RikusW/MegaU2S/Applications/Readme.md

# U2S Applications
[Example\_Echo\_test](Example_Echo_test) and [Example\_Echo\_test\_asm](Example_Echo_test_asm) Demo code using bootloader CDC driver from application code.  
[Example\_Pulse\_Counter](Example_Pulse_Counter)  
[Example\_SPI\_master](Example_SPI_master)  
[USB Blaster](Blaster20131026)  

# PC side applications
[u2scli](u2scli) Linux commandline interface to change modes  
[U2S\_GUI](U2S_GUI) Windows GUI to change modes and more  
[U2S\_Settings](U2S_Settings)  
[U2S\_Debug](U2S_Debug) Debug applications locally instead of on the AVR  

# Other AVR firmware
[ATmega8\_bootloader](ATmega8_bootloader) AVR UART bootloader
