RikusW/MegaU2S/Documentation/Images.md

# U2S:
U2S PCB
  
Artwork  
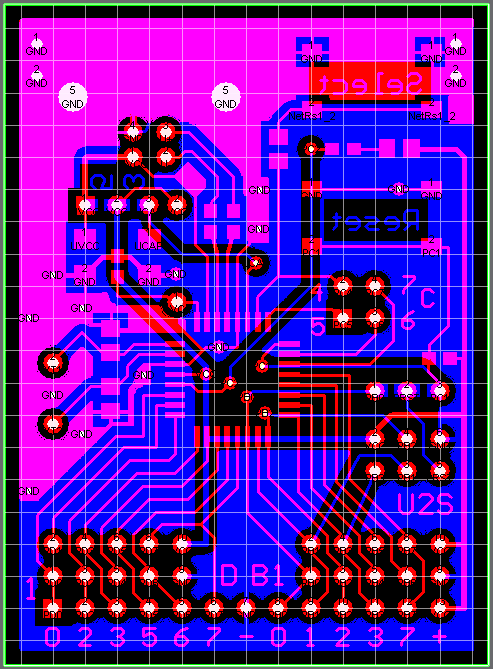
[picture p2: Documentation/files/U2S.png]
U2S artwork

  
# Extension Boards
There are 20 sets of 3 extension boards available, a HVPP board, a level translator board and a pinout adapter board for common Atmel pinouts. Thanks to megal0maniac for taking these highres photos :) [Imgur page](https://imgur.com/a/rblx5#0)  
  
HVPP/HVSP board (ST662)  
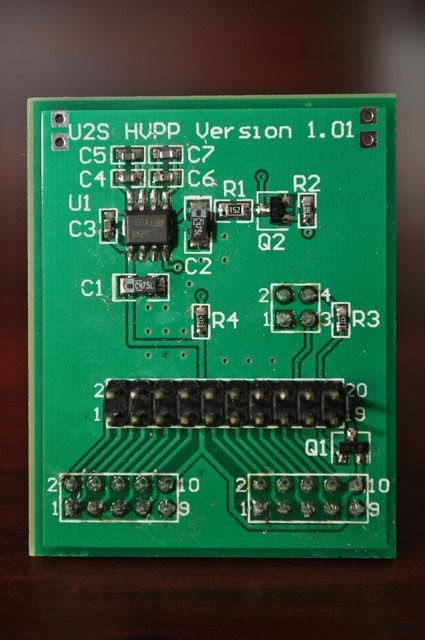
[picture p3: Documentation/files/V101_HVPP.jpg]

  
Level translator board (GTL2000DL)  
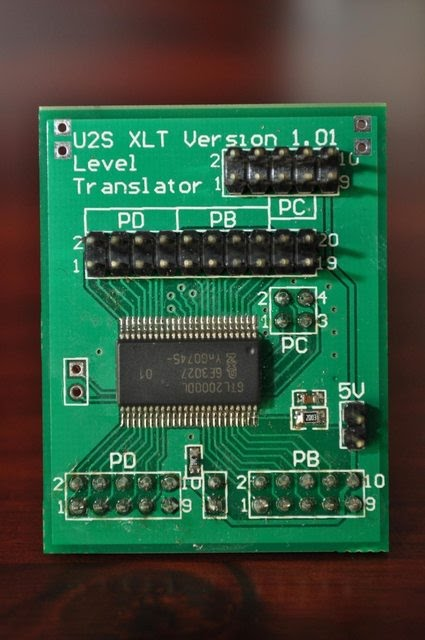
[picture p4: Documentation/files/V101_XLT.jpg]

  
Programming pinout adapter (TPI,PDI,ISP,JTAG)  
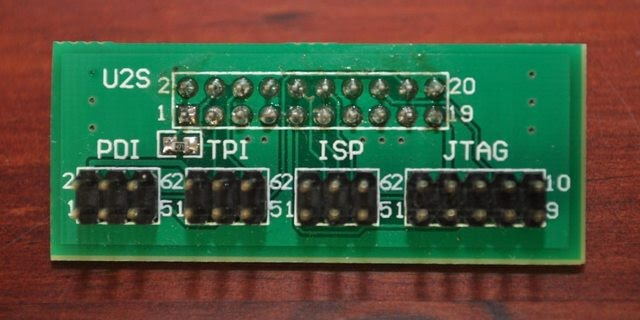
[picture p5: Documentation/files/V101_Pinout.jpg]

  
Full stack  
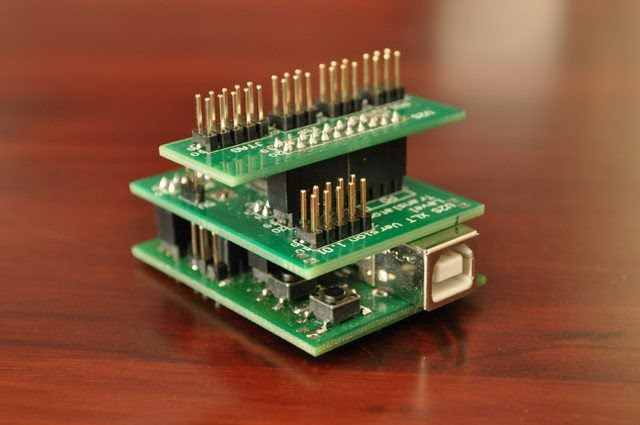
[picture p6: Documentation/files/V101_stack.jpg]

  
Artwork  
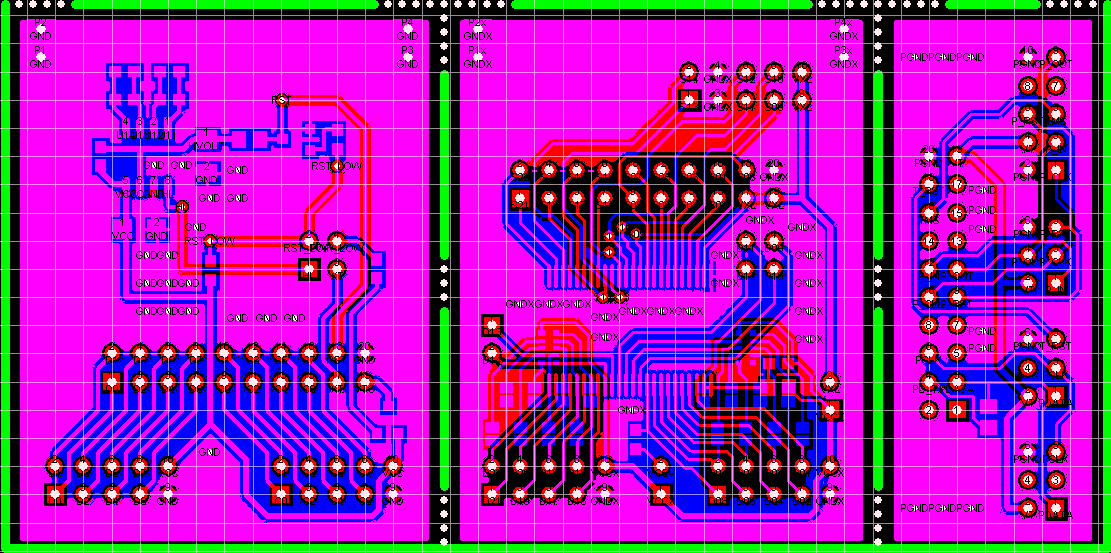
[picture p7: Documentation/files/V101_artwork.png]
Extension artwork

  
## Homemade artwork:

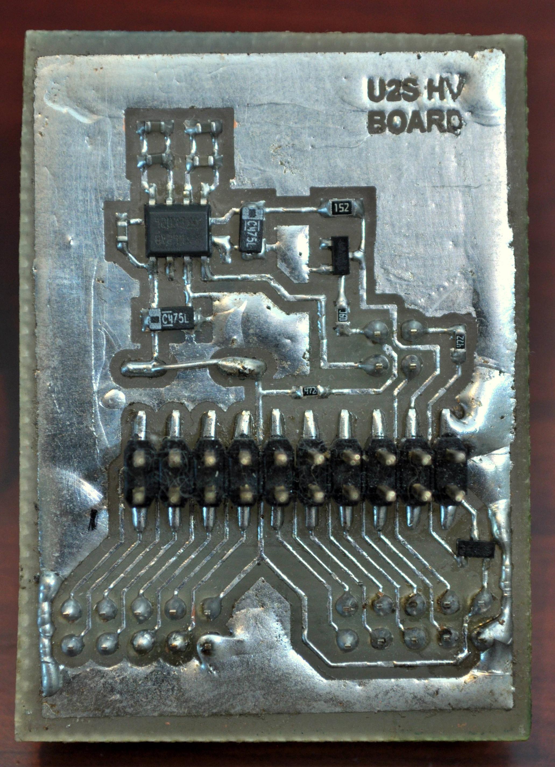
[picture p8: Documentation/files/HVPP_ST662_photo.jpg]
Homemade HVPP PCB

  
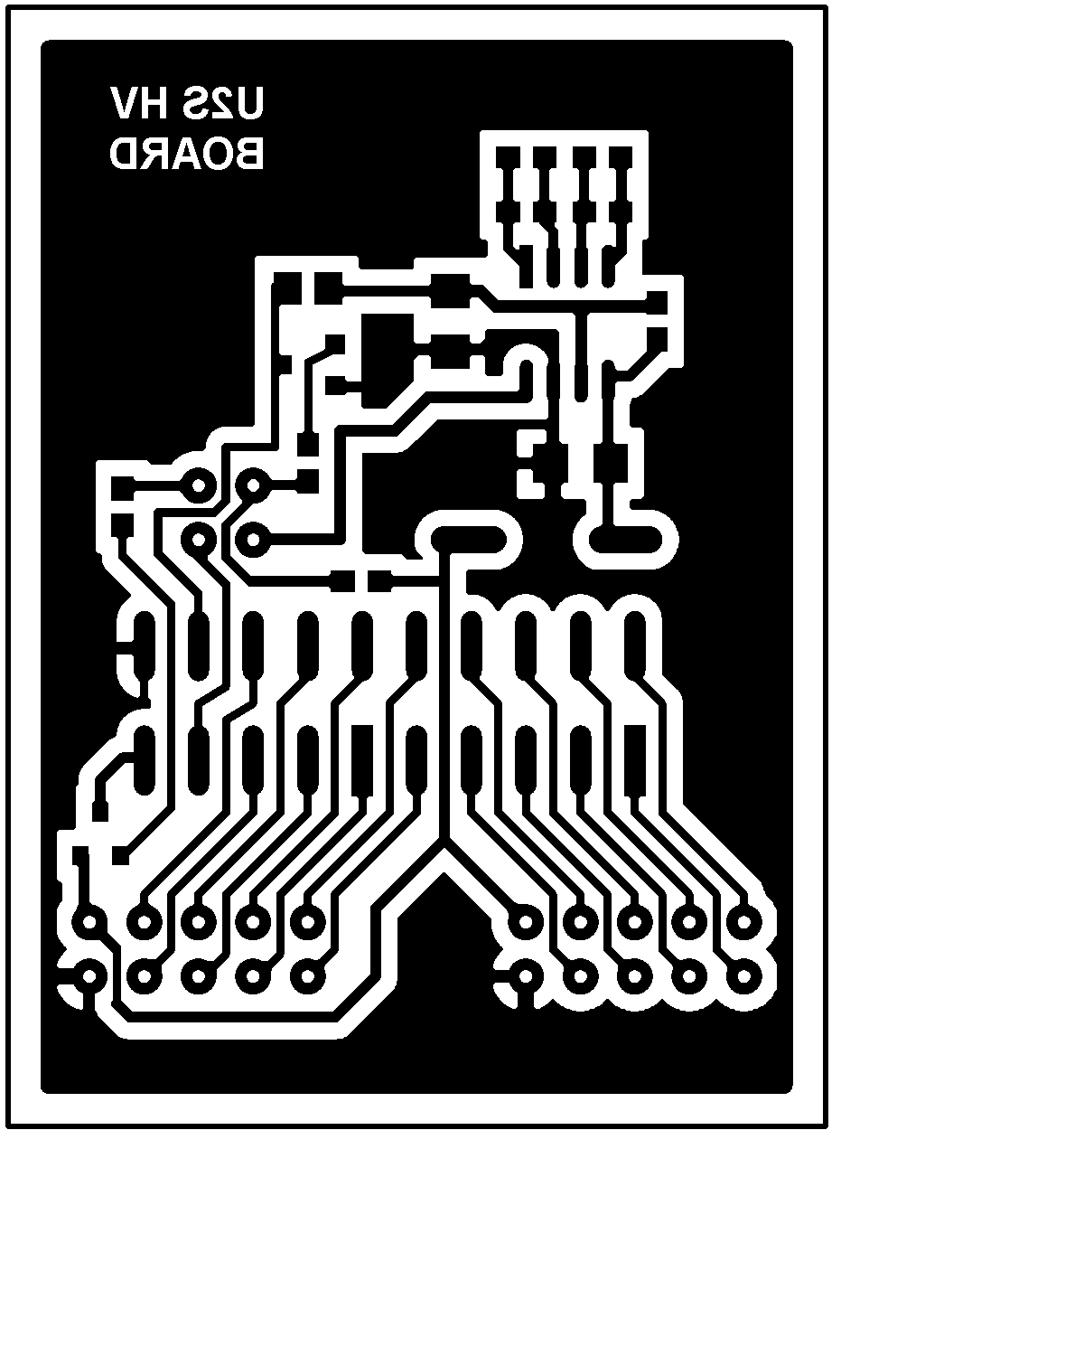
[picture p9: Documentation/files/HVPP_ST662_600dpi.png]
Homemade HVPP artwork
