RikusW/MegaU2S/(list of files, cad)

Other CAD files:
Applications/Example_Echo_test_asm/U2Sfw_asm.obj
