RikusW/MegaU2S/Altium/U2S_DXP/Test32U2.PcbDoc.htm

Altium Reporting Options

# File in Previous Format

Date | : | 6/8/2013
Time | : | 9:14:13 PM
Filename | : | C:\Documents and Settings\Rikus\My Documents\AVR_U2S\U2S_DXP\Test32U2.PcbDoc

Version | Warning
6.3 | CAUTION - Via connections to both hatched and solid signal layer polygons are now controlled by the polygon connect style rule. Re-pouring polygons may result in physical copper differences.
Summer 09 | CAUTION - File contains old violation objects. These violations are no longer supported & will not be loaded. Please run DRC after opening this file in order to refresh the violations.
Summer 09 | CAUTION - Existing testpoint rules and settings are used as fabrication testpoint information.

This file was generated by an earlier version of the software
