RikusW/MegaU2S/Applications/U2S_Debug/Readme.txt

Use U2S debug mode to access IO registers from code on PC
