RikusW/MegaU2S/(list of files, drawings)

Other design files:
Altium/U2S_DXP/ATMega32U2.PcbLib
Altium/U2S_DXP/ATMega32U2.SchLib
Altium/U2S_DXP/HC49.PcbLib
Altium/U2S_DXP/HC49.SchLib
Altium/U2S_DXP/MTS-1132.PcbLib
Altium/U2S_DXP/MTS-1132.SchLib
Altium/U2S_DXP/Test32U2.PcbDoc
Altium/U2S_DXP/Test32U2.PrjPCB
Altium/U2S_DXP/Test32U2.SchDoc
Altium/U2S_DXP/USBB.PcbLib
Altium/U2S_DXP/USBB.SchLib
Altium/U2S_HVPP_DXP/MiscComponents.PcbLib
Altium/U2S_HVPP_DXP/MiscComponents.SchLib
Altium/U2S_HVPP_DXP/U2S_HVPP.PCBDOC
Altium/U2S_HVPP_DXP/U2S_HVPP.PcbLib
Altium/U2S_HVPP_DXP/U2S_HVPP.PrjPCB
Altium/U2S_HVPP_DXP/U2S_HVPP.SchDoc
Altium/U2S_HVPP_DXP/U2S_HVPP.SchLib
Altium/U2S_HVPP_DXP/U2S_HVPP_OLD.PcbDoc
Altium/U2S_HVPP_DXP/U2S_ISP_JTAG.SchDoc
Altium/U2S_HVPP_DXP/U2S_TOP.SchDoc
Altium/U2S_HVPP_DXP/U2S_XLAT.SchDoc
