RikusW/MegaU2S/Applications/U2S_Settings/StdAfx.cpp

// stdafx.cpp : source file that includes just the standard includes
//	U2S_Settings.pch will be the pre-compiled header
//	stdafx.obj will contain the pre-compiled type information

#include "stdafx.h"
