RikusW/MegaU2S/Applications/U2S_Settings/resource.h

//{{NO_DEPENDENCIES}}
// Microsoft Developer Studio generated include file.
// Used by U2S_Settings.rc
//
#define IDM_ABOUTBOX                    0x0010
#define IDD_ABOUTBOX                    100
#define IDS_ABOUTBOX                    101
#define IDD_U2S_SETTINGS_DIALOG         102
#define IDR_MAINFRAME                   128
#define IDC_COMBO_MODE                  1000
#define IDC_COMBO_ISP                   1001
#define IDC_BREFRESH                    1002
#define IDC_EMSG                        1003
#define IDC_BDEFAULTS                   1004

// Next default values for new objects
// 
#ifdef APSTUDIO_INVOKED
#ifndef APSTUDIO_READONLY_SYMBOLS
#define _APS_NEXT_RESOURCE_VALUE        129
#define _APS_NEXT_COMMAND_VALUE         32771
#define _APS_NEXT_CONTROL_VALUE         1005
#define _APS_NEXT_SYMED_VALUE           101
#endif
#endif
