RikusW/MegaU2S/Firmware/JtagIce/Debug.asm

#ifdef DEBUG
//for debugging in the simulator

inject:
.db 0x53,0x20,0x20,0x00,0x00,0x00,0x00,0x00 //signon
.db 0x42,0x86,0xFA,0x20,0x20,0x00,0x00,0x00 //setparameter
.db 0x42,0x88,0xA5,0x20,0x20,0x00,0x00,0x00 //setparameter
.db 0x42,0x89,0xA6,0x20,0x20,0x00,0x00,0x00 //setparameter
.db 0x42,0x8A,0xA7,0x20,0x20,0x00,0x00,0x00 //setparameter
.db 0x71,0x62,0x20,0x20,0x00,0x00,0x00,0x00 //getparameter
.db 0x62,0x63,0x62,0x63,0x20,0x20,0x20,0x20
.db 0x00,0x00,0x00,0x00,0x00,0x00,0x00,0x00
.db 0xa3,0x20,0x20,0x00,0x00,0x00,0x00,0x00
.db 0x00,0x00,0x00,0x00,0x00,0x00,0x00,0x00
.db 0x00,0x00,0x00,0x00,0x00,0x00,0x00,0x00
.db 0x00,0x00,0x00,0x00,0x00,0x00,0x00,0x00
.db 0,0xA0 //Set Device Descriptor -- tested ok
.db 0xCF,0x2F,0xFF,0xFF,0xFF,0xFF,0xFF,0xFF,0x00,0x00,0x00,0x00,0x00,0x00,0x00,0x00
.db 0xCF,0x27,0xFF,0xFF,0xFF,0xFF,0xFF,0xFE,0x00,0x00,0x00,0x00,0x00,0x00,0x00,0x00
.db 0x3E,0xB5,0x1F,0x37,0xFF,0x1F,0x21,0x2F,0x00,0x00,0x00,0x00,0x00,0x00,0x00,0x00,0x00,0x00,0x00,0x00
.db 0x00,0x00,0x00,0x00,0x00,0x00,0x00,0x00,0x00,0x00,0x00,0x00,0x00,0x00,0x00,0x00,0x00,0x00,0x00,0x00
.db 0x3E,0xB5,0x0F,0x27,0xFF,0x1F,0x21,0x27,0x00,0x00,0x00,0x00,0x00,0x00,0x00,0x00,0x00,0x00,0x00,0x00
.db 0x00,0x00,0x00,0x00,0x00,0x00,0x00,0x00,0x00,0x00,0x00,0x00,0x00,0x00,0x00,0x00,0x00,0x00,0x00,0x00
.db 0x22, 0x68, 0x3B, 0, 1, 8, 0x00, 0xFE, 0x00, 0x00, 0x9D, 0x20,0x20,0


getc: //debug
	push	r30
	push	r31
	movw	r30,r26
	lpm		r16,Z+
	movw	r26,r30
	pop		r31
	pop		r30
	ret
/*
peekc:
	ldi		r26,lo8(inject*2)
	ldi		r27,hi8(inject*2)
	add		r26,r3    //db
	adc		r27,rnull //db
	clz //always available*/
flush:
	ret
putc:
	ret
putc_nf:
	ret

#endif
