RikusW/MegaU2S/Applications/U2S_GUI/resource.h

//{{NO_DEPENDENCIES}}
// Microsoft Developer Studio generated include file.
// Used by U2S_GUI.rc
//
#define IDM_ABOUTBOX                    0x0010
#define IDD_ABOUTBOX                    100
#define IDS_ABOUTBOX                    101
#define IDD_U2S_GUI_DIALOG              102
#define IDR_MAINFRAME                   128
#define IDD_DIALOG_DEBUG                131
#define IDD_U2S_DEBUG                   131
#define IDD_U2S_SETTINGS_DIALOG         132
#define IDD_U2S_USART                   133
#define IDC_CHECK1                      1001
#define IDC_CHECK2                      1002
#define IDC_CHECK3                      1003
#define IDC_CHECK4                      1004
#define IDC_CHECK5                      1005
#define IDC_CHECK6                      1006
#define IDC_CHECK7                      1007
#define IDC_CHECK8                      1008
#define IDC_EDIT1                       1009
#define IDC_EDIT2                       1010
#define IDC_EDIT3                       1011
#define IDC_EDIT4                       1012
#define IDC_EDIT5                       1013
#define IDC_EDIT6                       1014
#define IDC_EDIT7                       1015
#define IDC_EDIT8                       1016
#define IDC_LIST1                       1017
#define IDC_BUTTON1                     1018
#define IDC_BUTTON2                     1019
#define IDC_BUTTON3                     1020
#define IDC_BUTTON4                     1021
#define IDC_CHECK9                      1022
#define IDC_BUTTON8                     1022
#define IDC_BUTTON5                     1023
#define IDC_EDIT9                       1024
#define IDC_EDIT10                      1025
#define IDC_BUTTON6                     1026
#define IDC_EDIT11                      1027
#define IDC_BUTTON7                     1028
#define IDC_BUTTON9                     1029
#define IDC_EDIT12                      1030
#define IDC_COMBO1                      1031
#define IDC_BUTTON10                    1032
#define IDC_COMBO2                      1032
#define IDC_COMBO_MODE                  1033
#define IDC_BUTTON11                    1033
#define IDC_COMBO3                      1033
#define IDC_COMBO_ISP                   1034
#define IDC_BUTTON12                    1034
#define IDC_COMBO4                      1034
#define IDC_BREFRESH                    1035
#define IDC_COMBO5                      1035
#define IDC_EMSG                        1036
#define IDC_BDEFAULTS                   1037

#define IDC_RADIO1                      1037
#define IDC_RADIO2                      1038
#define IDC_RADIO3                      1039
#define IDC_RADIO4                      1040

#define IDC_STATIC1                     1041
#define IDC_STATIC2                     1042
#define IDC_STATIC_BAUD                 1043

// Next default values for new objects
// 
#ifdef APSTUDIO_INVOKED
#ifndef APSTUDIO_READONLY_SYMBOLS
#define _APS_NEXT_RESOURCE_VALUE        136
#define _APS_NEXT_COMMAND_VALUE         32771
#define _APS_NEXT_CONTROL_VALUE         1044
#define _APS_NEXT_SYMED_VALUE           101
#endif
#endif
