RikusW/MegaU2S/(commit log)

2022-10-30 Added Altium design files
    [ATMega32U2.PcbLib, ATMega32U2.SchLib, HC49.PcbLib, HC49.SchLib, MTS-1132.PcbLib, MTS-1132.SchLib, MiscComponents.PcbLib, MiscComponents.SchLib]
2022-10-30 Added driver files
2022-10-30 Added USB Driver doc
2022-10-30 Added UART doc
2022-10-30 Moved UART to Modules
2022-10-30 Updated USB Driver doc
2022-10-30 Moved code examples to Documentation
    [U2Sfw_asm.obj]
2022-10-31 Added SPI master example
2022-10-31 Moved Example code to Applications
    [U2Sfw_asm.obj]
2024-06-10 Set CDC protocol = 0, ModemManager fix
    [BL32U2.asm]
